bit-hack/iceXt/hardware/BOM_MiniXt_2025-11-12.csv

ID | Name | Designator | Footprint | Quantity | Manufacturer Part | Manufacturer | Supplier | Supplier Part | Price
1 | 22kΩ | R39,R40,R41,R42,R43,R44 | R0402 | 6 | 0402WGF2202TCE | UNI-ROYAL(厚声) | LCSC | C25768 | 0.001
2 | 10uF | C15,C3,C4 | CAP-SMD_L3.2-W1.6-RD-C7171 | 3 | TAJA106K016RNJ | Kyocera AVX | LCSC | C7171 | 0.116
3 | 10nF | C6 | C0402 | 1 | CL05B103KB5NNNC | SAMSUNG(三星) | LCSC | C15195 | 0.001
4 | 100nF | C13,C14,C2,C7,C8,C9,C10,C1,C5 | C0402 | 9 | CL05B104KB54PNC | SAMSUNG(三星) | LCSC | C307331 | 0.004
5 | 1473005-4 | CN1 | SO-DIMM-SMD_200P-P0.60_1473005-4 | 1 | 1473005-4 | TE Connectivity(泰科电子) | LCSC | C428482 | 3.903
6 | BSS138_C52895 | Q1,Q2,Q3,Q4 | SOT-23-3_L2.9-W1.6-P1.90-LS2.8-BR | 4 | BSS138 | onsemi(安森美) | LCSC | C52895 | 0.056
7 | 470Ω | R3,R4 | R0603 | 2 | 0603WAF4700T5E | UNI-ROYAL(厚声) | LCSC | C23179 | 0.001
8 | 3.3kΩ | R5 | R0603 | 1 | 0603WAF3301T5E | UNI-ROYAL(厚声) | LCSC | C22978 | 0.001
9 | 47kΩ | R6,R9,R10,R13,R14 | R0603 | 5 | 0603WAF4702T5E | UNI-ROYAL(厚声) | LCSC | C25819 | 0.001
10 | 2kΩ | RN1,RN10,RN3,RN5 | RES-ARRAY-SMD_0402-16P-L4.0-W1.6-BL-1 | 4 | 16P8WGF2001T4E | UNI-ROYAL(厚声) | LCSC | C422185 | 0.075
11 | 330Ω | R22,R23 | R0402 | 2 | 0402WGF3300TCE | UNI-ROYAL(厚声) | LCSC | C25104 | 0.001
12 | 47Ω | R24,R25,R7,R8 | R0603 | 4 | 0603WAF470JT5E | UNI-ROYAL(厚声) | LCSC | C23182 | 0.001
13 | 3.3kΩ | R26,R27,R28,R29,R11,R12,R15,R30 | R0402 | 8 | 0402WGF3301TCE | UNI-ROYAL(厚声) | LCSC | C25890 | 0.001
14 | DS1093-01-PN60 | KBD,MOUSE | CONN-TH_DS1093-01-PN60 | 2 | DS1093-01-PN60 | CONNFLY | LCSC | C77848 | 0.344
15 | KLJ-1230 | SPEAKER | BUZ-SMD_L12.0-W12.0 | 1 | KLJ-1230 | KELIKING(凯丽金) | LCSC | C201042 | 0.589
16 | DS1038-15FBNSIA74-0CC | VGA | DSUB-TH_DS1038-15FBNSIA74-0CC | 1 | DS1038-15FBNSiA74-0CC | CONNFLY | LCSC | C75754 | 0.413
17 | 470Ω | R2,R16,R17,R18,R19,R31,R32,R33,R34,R35,R36,R37,R38 | R0402 | 13 | 0402WGF4700TCE | UNI-ROYAL(厚声) | LCSC | C25117 | 0.001
18 | 10kΩ | R21 | R0402 | 1 | 0402WGF1002TCE | UNI-ROYAL(厚声) | LCSC | C25744 | 0.001
19 | PJ-3136-B | CN2 | AUDIO-TH_PJ-3136-B | 1 | PJ-3136-B | XKB Connectivity(中国星坤) | LCSC | C381131 | 0.106
20 | 503398-1892 | SDCARD | TF-SMD_503398-1892 | 1 | 5033981892 | MOLEX | LCSC | C428492 | 0.916
21 | 16-213/SDRC/S530-A3/TR8 | PWR,IO | LED0402-R-RD | 2 | 16-213SDRC/S530-A3/TR8 | EVERLIGHT(亿光) | LCSC | C71911 | 0.032
22 | TS665ZJ | RESET | SW-TH_TS665ZJ | 1 | TS665ZJ | SHOU HAN(首韩) | LCSC | C557599 | 0.031
23 | 10uF | C11 | C0402 | 1 | CL05A106MQ5NUNC | SAMSUNG(三星) | LCSC | C15525 | 0.005
24 | 100uF | C12 | C1206 | 1 | CL31A107MQHNNNE | SAMSUNG(三星) | LCSC | C15008 | 0.054
25 | 330Ω | R1 | R0603 | 1 | 0603WAF3300T5E | UNI-ROYAL(厚声) | LCSC | C23138 | 0.001
26 | 220kΩ | R20 | R0603 | 1 | 0603WAF2203T5E | UNI-ROYAL(厚声) | LCSC | C22961 | 0.001
27 | LMH6643MAX/NOPB | U3 | SOIC-8_L4.9-W3.9-P1.27-LS6.0-BL | 1 | LMH6643MAX/NOPB | TI(德州仪器) | LCSC | C44880 | 1.04
28 | AMS1117-3.3_C165482 | U4 | SOT-223_L6.5-W3.5-P2.30-LS7.0-BR | 1 | SK1117-3.3 | SHIKUES(时科) | LCSC | C165482 | 0.055
