bit-hack/iceXt/hardware/Schematic_MiniXt_2025-04-24.pdf

A | A

1

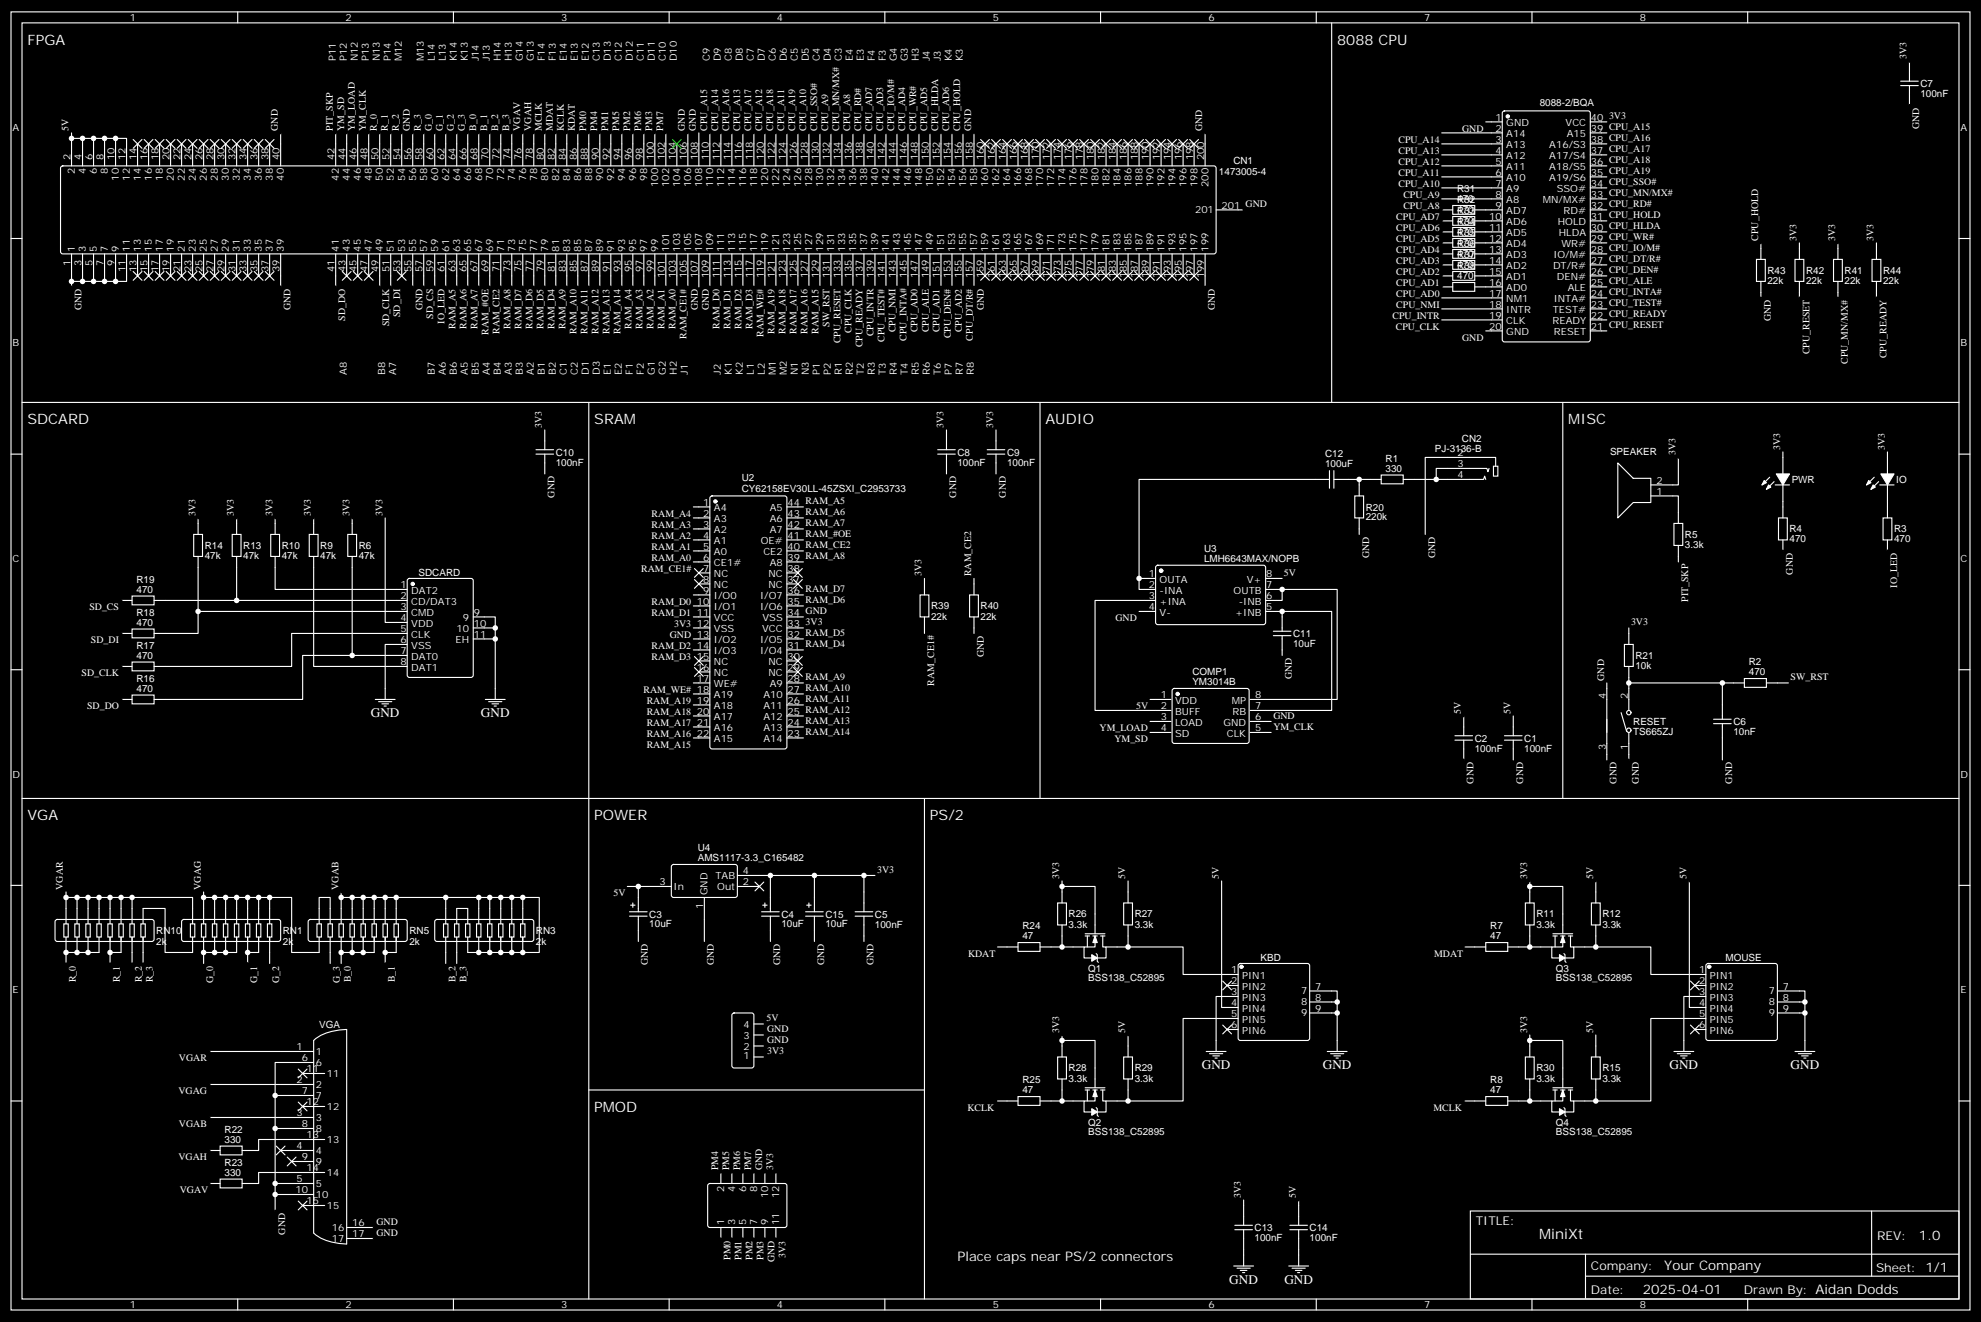
[picture p2: page 1]

Place caps near PS/2 connectors

Drawn By: Aidan Dodds
