bit-hack/iceXt/gateware/chipset/pic.v

/*     _          _  ________
 *    (_)_______ | |/ /_  __/
 *   / / ___/ _ \|   / / /
 *  / / /__/  __/   | / /
 * /_/\___/\___/_/|_|/_/
 *
**/
`default_nettype none


module pic(
  input            iClk,
  input            iRst,
  input            iIrq0,     // timer
  input            iIrq1,     // keyboard
  input            iIrq3,     // com2
  input            iIrq4,     // com1
  input            iIntAck,   // cpu->pic int ack
  input  [19:0]    iAddr,
  input  [ 7:0]    iWrData,
  input            iWr,
  input            iRd,
  output           oInt,      // cpu<-pic int req
  output reg       oSel,
  output reg [7:0] oData
);

  wire sel20h = (iAddr[11:0] == 12'h020);
  wire sel21h = (iAddr[11:0] == 12'h021);

  reg [7:0] isr = 0;  // in service
  reg [7:0] irr = 0;  // pending
  reg [7:0] imr = 0;  // mask register

  reg    intr = 0;
  assign oInt = intr;

  wire [7:0] irr_top =     // priority
  //            76543210
    irr[0] ? 8'b00000001  : // timer
    irr[1] ? 8'b00000010  : // keyboard
    irr[3] ? 6'b00001000  : // COM2
    irr[4] ? 8'b00010000  : // COM1
             8'b00000000;

  wire [7:0] isr_top =     // intr to code
  //            76543210
    isr[0] ? 8'b00000001  : // timer
    isr[1] ? 8'b00000010  : // keyboard
    isr[3] ? 8'b00001000  : // COM2
    isr[4] ? 8'b00010000  : // COM1
             8'b00000000;

  wire [7:0] irr_code =
    irr[0] ? 8'd0  :        // timer
    irr[1] ? 8'd1  :        // keyboard
    irr[3] ? 8'd3  :        // COM2
    irr[4] ? 8'd4  :        // COM1
             8'd0;

  wire [7:0] irq  = { 3'b000, iIrq4, iIrq3, 1'b0, iIrq1, iIrq0 };
  wire [7:0] irqe   = (irq ^ irqd) & irq;   // IRQ positive edges
  reg  [7:0] irqd   = 0;                    // IRQ delay (for edge detection)
  reg        ack_ff = 0;

  // irr after latching new requests
  wire [7:0] irr_next = irr | (irqe & ~imr);

  always @(posedge iClk) begin

    oSel <= 0;

    // delay to for edge detector
    irqd <= irq;

    // assert intr if highest pending not masked by any higher being serviced
    intr <= irr_top[0] ? !|isr_top[  0] :
            irr_top[1] ? !|isr_top[1:0] :
            irr_top[3] ? !|isr_top[3:0] :
            irr_top[4] ? !|isr_top[4:0] :
            1'b0;

    // latch new interrupts
    irr <= irr_next;

    if (iIntAck) begin
      // we get ack'd twice, the first one has to be ignored
      ack_ff <= !ack_ff;
      if (ack_ff) begin
        isr <= isr      |  irr_top;
        // lower acked interrupt
        irr <= irr_next & ~irr_top; 
        // vector code/address
        oData <= 8'd8 + irr_code;
        oSel  <= 1;
      end
    end

    if (iWr) begin
      if (sel20h) begin
        // EOI
        if (iWrData == 8'h20) begin
          // remove highest priority bit from ISR
          isr <= isr & ~isr_top;
        end
      end
      if (sel21h) begin
        imr <= iWrData;
      end
    end

    if (iRd) begin
      if (sel21h) begin
        oData <= imr;
        oSel  <= 1;
      end
    end

    // handle resets
    if (iRst) begin
      irr    <= 0;
      isr    <= 0;
      imr    <= 0;
      oData  <= 0;
      intr   <= 0;
      ack_ff <= 0;
      oSel   <= 0;
    end
  end

endmodule
