bit-hack/iceXt/gateware/clocks/pll.v

/*     _          _  ________
 *    (_)_______ | |/ /_  __/
 *   / / ___/ _ \|   / / /
 *  / / /__/  __/   | / /
 * /_/\___/\___/_/|_|/_/
 *
**/
`default_nettype none

`include "../config.vh"


`ifdef CFG_ENABLE_10MHZ
module pll
(
    input  clkin,   // 25 MHz, 0 deg
    output clkout0, // 10 MHz, 0 deg
    output clkout1, // 25 MHz, 0 deg
    output locked
);
(* FREQUENCY_PIN_CLKI="25" *)
(* FREQUENCY_PIN_CLKOP="10" *)
(* FREQUENCY_PIN_CLKOS="25" *)
(* ICP_CURRENT="12" *) (* LPF_RESISTOR="8" *) (* MFG_ENABLE_FILTEROPAMP="1" *) (* MFG_GMCREF_SEL="2" *)
EHXPLLL #(
        .PLLRST_ENA("DISABLED"),
        .INTFB_WAKE("DISABLED"),
        .STDBY_ENABLE("DISABLED"),
        .DPHASE_SOURCE("DISABLED"),
        .OUTDIVIDER_MUXA("DIVA"),
        .OUTDIVIDER_MUXB("DIVB"),
        .OUTDIVIDER_MUXC("DIVC"),
        .OUTDIVIDER_MUXD("DIVD"),
        .CLKI_DIV(5),
        .CLKOP_ENABLE("ENABLED"),
        .CLKOP_DIV(60),
        .CLKOP_CPHASE(30),
        .CLKOP_FPHASE(0),
        .CLKOS_ENABLE("ENABLED"),
        .CLKOS_DIV(24),
        .CLKOS_CPHASE(30),
        .CLKOS_FPHASE(0),
        .FEEDBK_PATH("CLKOP"),
        .CLKFB_DIV(2)
    ) pll_i (
        .RST(1'b0),
        .STDBY(1'b0),
        .CLKI(clkin),
        .CLKOP(clkout0),
        .CLKOS(clkout1),
        .CLKFB(clkout0),
        .CLKINTFB(),
        .PHASESEL0(1'b0),
        .PHASESEL1(1'b0),
        .PHASEDIR(1'b1),
        .PHASESTEP(1'b1),
        .PHASELOADREG(1'b1),
        .PLLWAKESYNC(1'b0),
        .ENCLKOP(1'b0),
        .LOCK(locked)
	);
endmodule
`endif

`ifdef CFG_ENABLE_16MHZ
module pll
(
    input  clkin,   // 25 MHz,      0 deg
    output clkout0, // 16.6667 MHz, 0 deg
    output clkout1, // 25 MHz,      0 deg
    output locked
);
(* FREQUENCY_PIN_CLKI="25" *)
(* FREQUENCY_PIN_CLKOP="16.6667" *)
(* FREQUENCY_PIN_CLKOS="25" *)
(* ICP_CURRENT="12" *) (* LPF_RESISTOR="8" *) (* MFG_ENABLE_FILTEROPAMP="1" *) (* MFG_GMCREF_SEL="2" *)
EHXPLLL #(
        .PLLRST_ENA("DISABLED"),
        .INTFB_WAKE("DISABLED"),
        .STDBY_ENABLE("DISABLED"),
        .DPHASE_SOURCE("DISABLED"),
        .OUTDIVIDER_MUXA("DIVA"),
        .OUTDIVIDER_MUXB("DIVB"),
        .OUTDIVIDER_MUXC("DIVC"),
        .OUTDIVIDER_MUXD("DIVD"),
        .CLKI_DIV(3),
        .CLKOP_ENABLE("ENABLED"),
        .CLKOP_DIV(36),
        .CLKOP_CPHASE(18),
        .CLKOP_FPHASE(0),
        .CLKOS_ENABLE("ENABLED"),
        .CLKOS_DIV(24),
        .CLKOS_CPHASE(18),
        .CLKOS_FPHASE(0),
        .FEEDBK_PATH("CLKOP"),
        .CLKFB_DIV(2)
    ) pll_i (
        .RST(1'b0),
        .STDBY(1'b0),
        .CLKI(clkin),
        .CLKOP(clkout0),
        .CLKOS(clkout1),
        .CLKFB(clkout0),
        .CLKINTFB(),
        .PHASESEL0(1'b0),
        .PHASESEL1(1'b0),
        .PHASEDIR(1'b1),
        .PHASESTEP(1'b1),
        .PHASELOADREG(1'b1),
        .PLLWAKESYNC(1'b0),
        .ENCLKOP(1'b0),
        .LOCK(locked)
	);
endmodule
`endif

`ifdef CFG_ENABLE_20MHZ
module pll
(
    input clkin, // 25 MHz, 0 deg
    output clkout0, // 20 MHz, 0 deg
    output clkout1, // 25 MHz, 0 deg
    output locked
);
(* FREQUENCY_PIN_CLKI="25" *)
(* FREQUENCY_PIN_CLKOP="20" *)
(* FREQUENCY_PIN_CLKOS="25" *)
(* ICP_CURRENT="12" *) (* LPF_RESISTOR="8" *) (* MFG_ENABLE_FILTEROPAMP="1" *) (* MFG_GMCREF_SEL="2" *)
EHXPLLL #(
        .PLLRST_ENA("DISABLED"),
        .INTFB_WAKE("DISABLED"),
        .STDBY_ENABLE("DISABLED"),
        .DPHASE_SOURCE("DISABLED"),
        .OUTDIVIDER_MUXA("DIVA"),
        .OUTDIVIDER_MUXB("DIVB"),
        .OUTDIVIDER_MUXC("DIVC"),
        .OUTDIVIDER_MUXD("DIVD"),
        .CLKI_DIV(5),
        .CLKOP_ENABLE("ENABLED"),
        .CLKOP_DIV(30),
        .CLKOP_CPHASE(15),
        .CLKOP_FPHASE(0),
        .CLKOS_ENABLE("ENABLED"),
        .CLKOS_DIV(24),
        .CLKOS_CPHASE(15),
        .CLKOS_FPHASE(0),
        .FEEDBK_PATH("CLKOP"),
        .CLKFB_DIV(4)
    ) pll_i (
        .RST(1'b0),
        .STDBY(1'b0),
        .CLKI(clkin),
        .CLKOP(clkout0),
        .CLKOS(clkout1),
        .CLKFB(clkout0),
        .CLKINTFB(),
        .PHASESEL0(1'b0),
        .PHASESEL1(1'b0),
        .PHASEDIR(1'b1),
        .PHASESTEP(1'b1),
        .PHASELOADREG(1'b1),
        .PLLWAKESYNC(1'b0),
        .ENCLKOP(1'b0),
        .LOCK(locked)
	);
endmodule
`endif 
