bit-hack/iceXt/gateware/utils/reset.v

/*     _          _  ________
 *    (_)_______ | |/ /_  __/
 *   / / ___/ _ \|   / / /
 *  / / /__/  __/   | / /
 * /_/\___/\___/_/|_|/_/
 *
**/
`default_nettype none


module reset (
    input  iClk,
    input  iReset,
    output oReset   // active high
);

  parameter BITS = 8;

  reg [BITS-1:0] rstCnt = 0;
  wire rst = ~&rstCnt;
  assign oReset = rst;

  always @(posedge iClk) begin
    rstCnt <= iReset ? 0 : (rstCnt + rst);
  end
endmodule
