bit-hack/iceXt/(commit log)

2025-04-25 Test YM3014 with JTOPL2 uart rx device
2025-04-30 Fix 8088 bus pipeline bug
    [top.v]
2025-05-01 Wire up SRAM
2025-05-01 Fix mda layout and get landmark to boot
    [top.v]
2025-05-02 Fix interrupt line layout
    [pic.v, top.v]
2025-05-08 Work on SPI diskrom
2025-05-08 Fix some diskrom bugs
    [cpu.c, cpu.h, disk.c, main.c]
2025-05-11 Add Port 61h and PIT prototype
2025-05-17 Add active SPI send delay polling
2025-05-17 Fix adlib for adjustable cpu speeds
    [adlib.v]
2025-05-20 Sort out loose ends of EGA
    [display.c, main.c]
2025-05-27 Sketch up an 8250 uart
2025-11-12 Upload gerber files and BOM
    [BOM_MiniXt_2025-11-12.csv]
